alantrundle/P4-Airplay2-4inCtsLVGL/KiCAD PCB Files/P4-Audio-TFT/Footprints/FT6236_TOUCH/README.txt

V3 photo-corrected touch footprint
Common datum is panel centre. Place DS1 and TS1 at identical X/Y/rotation.
Panel/reference outline: 60.88 x 94.57 mm
6P connector centre: X=-8.50, Y=37.285 mm
Lower panel edge to 6P connector centre: 10.0 mm (short tail)
6P connector body LEFT edge aligns with 40P connector body LEFT edge.
3D model is bezel only, above TFT.
