alantrundle/P4-Airplay2-4inCtsLVGL/KiCAD PCB Files/P4-Audio-TFT/Footprints/ILI9488_TFT/README.txt

V3 photo-corrected TFT footprint
Common datum is panel centre. Place DS1 and TS1 at identical X/Y/rotation.
Panel: 60.88 x 94.57 mm
40P connector centre: X=0.00, Y=4.785 mm
Lower panel edge to 40P connector centre: 42.5 mm
TFT STEP bottom: 2.0 mm above PCB
