alantrundle/P4-Airplay2-4inCtsLVGL/KiCAD PCB Files/P4-Audio-TFT/Revision-in-progress.md

# Layout completed — 19 October 2026

The schematic, PCB, BOM, placement and Gerber/drill files are updated in this project. Native DRC, ERC, unconnected-item and schematic-parity checks all have zero findings. The current native reports are in validation/.

Use production/P4-Audio-TFT.zip, production/bom.csv and production/positions.csv together. Previous manufacturing files are archived in archive/production-before-release-20261019. A pre-release source backup is P4-Audio-TFT-before-release-20261019.zip.

Assembly sourcing is blocked: U1/P4 and U8/LD39150 have no JLC stock; U9/C6 has only two available for five boards. See the refreshed BOM workbook. This is a checked prototype layout, not tested hardware; the long SD-card routing and bring-up limits are described in Design-review.md and production/README.md.
