alantrundle/P4-Airplay2-4inCtsLVGL/KiCAD PCB Files/P4-PCB3-WIFI6-DB/Bottom-placement.png

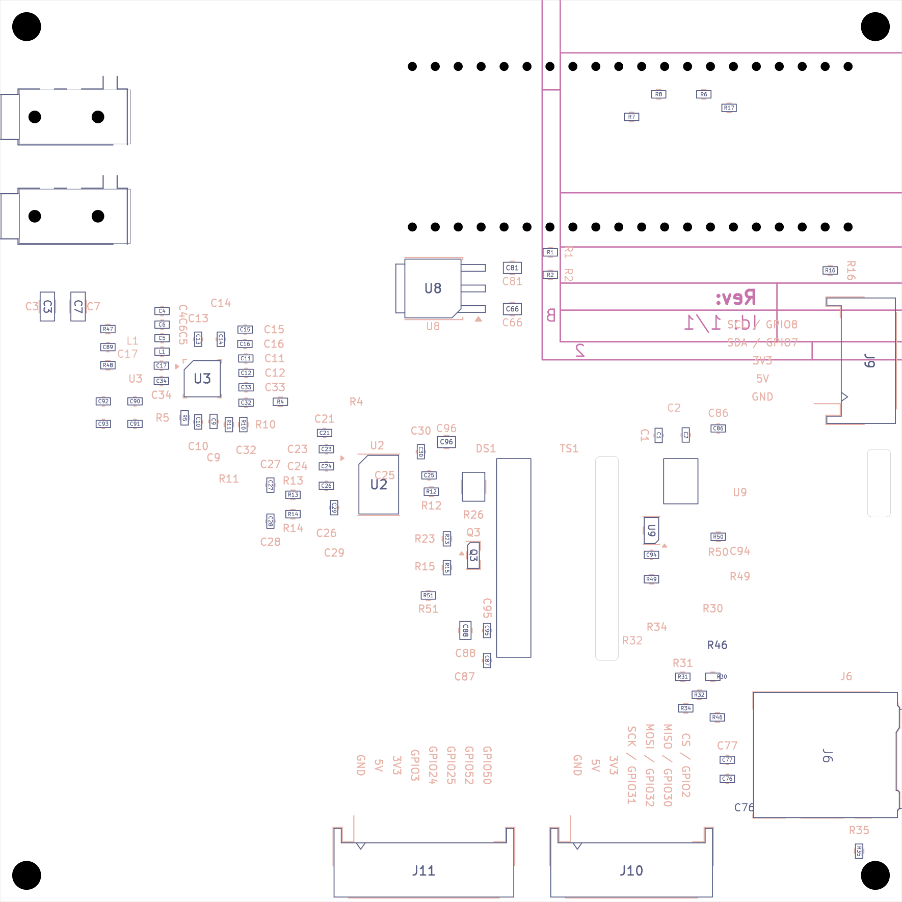
KiCAD PCB Files/P4-PCB3-WIFI6-DB/Bottom-placement.png
