alantrundle/P4-Airplay2-4inCtsLVGL/KiCAD PCB Files/P4-PCB3-WIFI6-DB/Top-placement.png

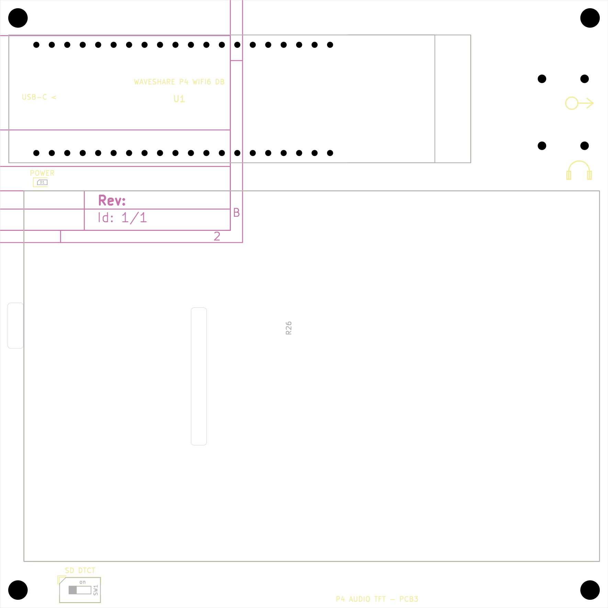
KiCAD PCB Files/P4-PCB3-WIFI6-DB/Top-placement.png
