alantrundle/P4-Airplay2-4inCtsLVGL/KiCAD PCB Files/P4-PCB3-WIFI6-DB/BOM-full.csv

Designator | Comment | Footprint | LCSC Part # | Quantity | Assembly | Notes
C1,C2 | 220pF | P4Local_Capacitor_SMD:C_0603_1608Metric | C1603 | 2 | Do not place | Optional I2C filter capacitors omitted.
C3,C7 | 100uF | P4Local_Capacitor_SMD:C_1206_3216Metric | C15008 | 2 | JLCPCB
C4 | 4.7uF | P4Local_Capacitor_SMD:C_0603_1608Metric | C19666 | 1 | JLCPCB
C5,C6,C10,C12,C14,C16,C17,C23,C25,C29,C30,C33,C34,C77,C86,C94,C95 | 100nF | P4Local_Capacitor_SMD:C_0603_1608Metric | C14663 | 17 | JLCPCB
C9,C11,C13,C15,C21,C32,C76 | 10uF | P4Local_Capacitor_SMD:C_0603_1608Metric | C19702 | 7 | JLCPCB
C24,C26,C89 | 2.2uF | P4Local_Capacitor_SMD:C_0603_1608Metric | C23630 | 3 | JLCPCB
C27,C28 | 2.2nF | P4Local_Capacitor_SMD:C_0603_1608Metric | C1604 | 2 | JLCPCB
C66,C81,C96 | 10uF | P4Local_Capacitor_SMD:C_0805_2012Metric | C15850 | 3 | JLCPCB
C87,C90,C91 | 1uF | P4Local_Capacitor_SMD:C_0603_1608Metric | C15849 | 3 | JLCPCB
C88 | 22uF | P4Local_Capacitor_SMD:C_0805_2012Metric | C45783 | 1 | JLCPCB
C92,C93 | 100pF | P4Local_Capacitor_SMD:C_0603_1608Metric | C14858 | 2 | JLCPCB
D1 | Green LED | P4Local_LED_SMD:LED_0603_1608Metric | C12624 | 1 | Manual fit | Top-side part excluded from bottom-only JLCPCB assembly; purchase separately and hand fit.
DS1 | FH34SRJ-40S-0.5SH(50) | P4Local_Updated:ILI9488_40P_4inch_Checked | C506798 | 1 | JLCPCB
J2,J3 | PJ-320D | P4Local_Connector_Audio_Han:HanElectricity_PJ320D_C22459515 | C22459515 | 2 | JLCPCB
J6 | DM3AT-SF-PEJM5 | P4Local_Connector_Card:microSD_HC_Hirose_DM3AT-SF-PEJM5 | C114218 | 1 | JLCPCB
J9 | S5B-PH-SM4-TB(LF)(SN) | P4Local_Connector_JST:JST_PH_S5B-PH-SM4-TB_1x05-1MP_P2.00mm_Horizontal | C265104 | 1 | JLCPCB
J10 | S7B-PH-SM4-TB(LF)(SN) | P4Local_Connector_JST:JST_PH_S7B-PH-SM4-TB_1x07-1MP_P2.00mm_Horizontal | C265453 | 1 | JLCPCB
J11 | S8B-PH-SM4-TB(LF)(SN) | P4Local_Connector_JST:JST_PH_S8B-PH-SM4-TB_1x08-1MP_P2.00mm_Horizontal | C265121 | 1 | JLCPCB
L1 | 600R@100MHz Ferrite | P4Local_Inductor_SMD:L_0603_1608Metric | C107335 | 1 | JLCPCB
Q3 | AO3400A | P4Local_Package_TO_SOT_SMD:SOT-23 | C20917 | 1 | JLCPCB
R1,R2 | 4.7k | P4Local_Resistor_SMD:R_0603_1608Metric | C23162 | 2 | JLCPCB
R4 | 10R | P4Local_Resistor_SMD:R_0603_1608Metric | C22859 | 1 | JLCPCB
R5,R6,R7,R8,R17 | 33R | P4Local_Resistor_SMD:R_0603_1608Metric | C23140 | 5 | JLCPCB
R10,R11 | 22R | P4Local_Resistor_SMD:R_0603_1608Metric | C23345 | 2 | JLCPCB
R12,R30,R31,R32,R34,R35,R46,R49,R50,R51 | 10k | P4Local_Resistor_SMD:R_0603_1608Metric | C25804 | 10 | JLCPCB
R13,R14 | 470R | P4Local_Resistor_SMD:R_0603_1608Metric | C23179 | 2 | JLCPCB
R15 | 100R | P4Local_Resistor_SMD:R_0603_1608Metric | C22775 | 1 | JLCPCB
R16 | 5.1k | P4Local_Resistor_SMD:R_0603_1608Metric | C23186 | 1 | JLCPCB
R23 | 100k | P4Local_Resistor_SMD:R_0603_1608Metric | C25803 | 1 | JLCPCB
R26 | 22R 0.5W | P4Local_Resistor_SMD:R_1210_3225Metric | C2960863 | 1 | JLCPCB
R47 | 1k | P4Local_Resistor_SMD:R_0603_1608Metric | C21190 | 1 | JLCPCB
R48 | 2k | P4Local_Resistor_SMD:R_0603_1608Metric | C22975 | 1 | JLCPCB
SW1 | EM-01KP | P4Local_Button_Switch_SMD:SW_DIP_SPSTx01_Slide_6.7x4.1mm_W8.61mm_P2.54mm_LowProfile | C129077 | 1 | Manual fit | Top-side part excluded from bottom-only JLCPCB assembly; purchase separately and hand fit.
TS1 | FH34SRJ-6S-0.5SH(50) | P4Local_FT6236_TOUCH:Hirose_FH34SRJ-6S-0.5SH_FT6236 | C224194 | 1 | JLCPCB
U1 | ESP32-P4-WIFI6-DB | P4Carrier:Waveshare_P4_WIFI6_DB_Sockets |  | 1 | Do not place | Customer-fitted Waveshare module. Fit two female socket strips separately.
U2 | PCM5102APWR | P4Local_Package_SO:TSSOP-20_4.4x6.5mm_P0.65mm | C107671 | 1 | JLCPCB
U3 | ES8388 | P4Local_Package_DFN_QFN:QFN-28-1EP_4x4mm_P0.45mm_EP2.6x2.6mm | C365736 | 1 | JLCPCB
U8 | LD39150DT33-R | P4Local_Package_TO_SOT_SMD:TO-252-3_TabPin2 | C155559 | 1 | JLCPCB
U9 | SN74LVC1G125DBVR | P4Local_Package_TO_SOT_SMD:SOT-23-5 | C23654 | 1 | JLCPCB
U1 socket A, U1 socket B | 1x20 female socket, 2.54 mm pitch | Through-hole, 1.0 mm holes | C50984 | 2 | Manual fit | Through-hole fallback. Two independent single-row strips, 17.78 mm apart. Standard-height part; no verified low-profile SMT substitute selected.
