alantrundle/P4-Airplay2-4inCtsLVGL/KiCAD PCB Files/P4-Audio-TFT/P4-Audio-TFT-BOM-review.xlsx

P4 Audio TFT — component sourcing
Checked 19 October 2026. Prices in USD; assembly fees, PCB, VAT and delivery excluded.
Boards | 5 |  | Stocked assembly parts estimate |  |  |  | $95.53
 |  |  | Estimate including stock exceptions |  |  |  | $159.83
Assembly sourcing blocked: U1/P4 and U8/LDO out of stock; U9/C6 only 2 available for five boards.
Class | Designators | Value | Package | Per board | For 5 boards | Allocate estimate | JLC stock | Unit USD | Line USD | Availability | LCSC code | Manufacturer part | Manufacturer | Assembly minimum | Wastage allowance | Fit | Notes | Source
Basic | R16, R24, R27 | 5.1k | 0603 | 3 | 15 | 25 | 23342336 | 0.0015 | 0.04 | In stock | C23186 | 0603WAF5101T5E | UNI-ROYAL(Uniroyal Elec) | 20 | 10 | JLC assembly |  | https://jlcpcb.com/partdetail/part/C23186
Basic | R10, R11 | 22R | 0603 | 2 | 10 | 20 | 7646846 | 0.0017 | 0.03 | In stock | C23345 | 0603WAF220JT5E | UNI-ROYAL(Uniroyal Elec) | 20 | 10 | JLC assembly |  | https://jlcpcb.com/partdetail/part/C23345
Basic | R54, R55, R56, R57, R58, R59 | 51k | 0603 | 6 | 30 | 40 | 2399299 | 0.0017 | 0.07 | In stock | C23196 | 0603WAF5102T5E | UNI-ROYAL(Uniroyal Elec) | 20 | 10 | JLC assembly |  | https://jlcpcb.com/partdetail/part/C23196
Basic | R13, R14 | 470R | 0603 | 2 | 10 | 20 | 5492068 | 0.0023 | 0.05 | In stock | C23179 | 0603WAF4700T5E | UNI-ROYAL(Uniroyal Elec) | 20 | 10 | JLC assembly |  | https://jlcpcb.com/partdetail/part/C23179
Basic | R5, R6, R7, R8, R17 | 33R | 0603 | 5 | 25 | 35 | 4875893 | 0.0024 | 0.08 | In stock | C23140 | 0603WAF330JT5E | UNI-ROYAL(Uniroyal Elec) | 20 | 10 | JLC assembly |  | https://jlcpcb.com/partdetail/part/C23140
Basic | R48 | 2k | 0603 | 1 | 5 | 20 | 11221424 | 0.0024 | 0.05 | In stock | C22975 | 0603WAF2001T5E | UNI-ROYAL(Uniroyal Elec) | 20 | 10 | JLC assembly |  | https://jlcpcb.com/partdetail/part/C22975
Basic | R15 | 100R | 0603 | 1 | 5 | 20 | 10630717 | 0.0025 | 0.05 | In stock | C22775 | 0603WAF1000T5E | UNI-ROYAL(Uniroyal Elec) | 20 | 10 | JLC assembly |  | https://jlcpcb.com/partdetail/part/C22775
Basic | R1, R2 | 4.7k | 0603 | 2 | 10 | 20 | 18421225 | 0.0028 | 0.06 | In stock | C23162 | 0603WAF4701T5E | UNI-ROYAL(Uniroyal Elec) | 20 | 10 | JLC assembly |  | https://jlcpcb.com/partdetail/part/C23162
Basic | R47 | 1k | 0603 | 1 | 5 | 20 | 22808225 | 0.0030 | 0.06 | In stock | C21190 | 0603WAF1001T5E | UNI-ROYAL(Uniroyal Elec) | 20 | 10 | JLC assembly |  | https://jlcpcb.com/partdetail/part/C21190
Basic | R23, R37 | 100k | 0603 | 2 | 10 | 20 | 19181265 | 0.0031 | 0.06 | In stock | C25803 | 0603WAF1003T5E | UNI-ROYAL(Uniroyal Elec) | 20 | 10 | JLC assembly |  | https://jlcpcb.com/partdetail/part/C25803
Basic | R4 | 10R | 0603 | 1 | 5 | 20 | 5995370 | 0.0032 | 0.06 | In stock | C22859 | 0603WAF100JT5E | UNI-ROYAL(Uniroyal Elec) | 20 | 10 | JLC assembly |  | https://jlcpcb.com/partdetail/part/C22859
Basic | R51 | 10M | 0603 | 1 | 5 | 20 | 1055279 | 0.0032 | 0.06 | In stock | C7250 | 0603WAF1005T5E | UNI-ROYAL(Uniroyal Elec) | 20 | 10 | JLC assembly |  | https://jlcpcb.com/partdetail/part/C7250
Basic | C101, C115, C118 | 100nF | 0402 | 3 | 15 | 25 | 29163879 | 0.0051 | 0.13 | In stock | C1525 | CL05B104KO5NNNC | Samsung Electro-Mechanics | 20 | 10 | JLC assembly |  | https://jlcpcb.com/partdetail/part/C1525
Basic | R3, R9, R12, R18, R25, R29, R30, R31, R32, R33, R34, R35, R36, R46, R52, R53, R61, R62 | 10k | 0603 | 18 | 90 | 100 | 39228014 | 0.0054 | 0.54 | In stock | C25804 | 0603WAF1002T5E | UNI-ROYAL(Uniroyal Elec) | 20 | 10 | JLC assembly |  | https://jlcpcb.com/partdetail/part/C25804
Basic | C122, C123, C124, C125, C126 | 22pF | 0603 | 5 | 25 | 35 | 2131614 | 0.0060 | 0.21 | In stock | C1653 | CL10C220JB8NNNC | Samsung Electro-Mechanics | 20 | 10 | JLC assembly |  | https://jlcpcb.com/partdetail/part/C1653
Basic | C99, C102, C116 | 1uF | 0402 | 3 | 15 | 25 | 8393820 | 0.0068 | 0.17 | In stock | C52923 | CL05A105KA5NQNC | Samsung Electro-Mechanics | 20 | 10 | JLC assembly |  | https://jlcpcb.com/partdetail/part/C52923
Basic | C1, C2 | 220pF | 0603 | 2 | 10 | 20 | 1167880 | 0.0072 | 0.14 | In stock | C1603 | CL10B221KB8NNNC | Samsung Electro-Mechanics | 20 | 10 | JLC assembly |  | https://jlcpcb.com/partdetail/part/C1603
Basic | C92, C93 | 100pF | 0603 | 2 | 10 | 20 | 3988044 | 0.0086 | 0.17 | In stock | C14858 | CL10C101JB8NNNC | Samsung Electro-Mechanics | 20 | 10 | JLC assembly |  | https://jlcpcb.com/partdetail/part/C14858
Basic | C5, C6, C10, C12, C14, C16, C17, C18, C19, C22, C23, C25, C29, C30, C33, C34, C65, C77, C82, C85, C86, C94, C95, C96, C103, C104, C105, C107, C109, C110, C112, C114, C117, C127, C129, C131, C132, C133, C136, C137 | 100nF | 0603 | 40 | 200 | 210 | 40118497 | 0.0108 | 2.27 | In stock | C14663 | CC0603KRX7R9BB104 | YAGEO | 20 | 10 | JLC assembly |  | https://jlcpcb.com/partdetail/part/C14663
Basic | C27, C28 | 2.2nF | 0603 | 2 | 10 | 20 | 978911 | 0.0109 | 0.22 | In stock | C1604 | 0603B222K500NT | FH (Guangdong Fenghua Advanced Tech) | 20 | 10 | JLC assembly |  | https://jlcpcb.com/partdetail/part/C1604
Basic | C24, C26, C89 | 2.2uF | 0603 | 3 | 15 | 25 | 3395818 | 0.0134 | 0.34 | In stock | C23630 | CL10A225KO8NNNC | Samsung Electro-Mechanics | 20 | 10 | JLC assembly |  | https://jlcpcb.com/partdetail/part/C23630
Basic | Q4, Q5 | S8050 | SOT-23 | 2 | 10 | 15 | 1421059 | 0.0147 | 0.22 | In stock | C2146 | S8050 J3Y(RANGE:200-350) | Jiangsu Changjing Electronics Technology Co., Ltd. | 10 | 5 | JLC assembly | Two Basic S8050s plus two existing-type 10k base resistors replace unavailable EMH4T2R (Q1). | https://jlcpcb.com/partdetail/part/C2146
Basic | C75, C87, C90, C91, C97, C98, C100, C135 | 1uF | 0603 | 8 | 40 | 50 | 15235435 | 0.0153 | 0.77 | In stock | C15849 | CL10A105KB8NNNC | Samsung Electro-Mechanics | 20 | 10 | JLC assembly |  | https://jlcpcb.com/partdetail/part/C15849
Basic | D1 | Green LED | 0805 | 1 | 5 | 20 | 2611569 | 0.0164 | 0.33 | In stock | C2297 | KT-0805G | Hubei KENTO Elec | 20 | 10 | JLC assembly | Changed indicator to Basic 0805 green LED with matching footprint. | https://jlcpcb.com/partdetail/part/C2297
Basic | C4, C119, C120 | 4.7uF | 0603 | 3 | 15 | 25 | 3459949 | 0.0218 | 0.55 | In stock | C19666 | CL10A475KO8NNNC | Samsung Electro-Mechanics | 20 | 10 | JLC assembly |  | https://jlcpcb.com/partdetail/part/C19666
Basic | C9, C11, C13, C15, C21, C31, C32, C76, C106, C108, C111, C113, C128, C134 | 10uF | 0603 | 14 | 70 | 80 | 10697332 | 0.0272 | 2.18 | In stock | C19702 | CL10A106KP8NNNC | Samsung Electro-Mechanics | 20 | 10 | JLC assembly |  | https://jlcpcb.com/partdetail/part/C19702
Basic | C121, C130 | 22uF | 0603 | 2 | 10 | 20 | 7011157 | 0.0312 | 0.62 | In stock | C59461 | CL10A226MQ8NRNC | Samsung Electro-Mechanics | 20 | 10 | JLC assembly | 22uF 6.3V X5R 0603 on the P4 low-voltage core rail; Basic replacement for 16V part. | https://jlcpcb.com/partdetail/part/C59461
Basic | D3 | SS34 | SMA(DO-214AC) | 1 | 5 | 13 | 3811369 | 0.0350 | 0.46 | In stock | C8678 | SS34 | MDD(Microdiode Semiconductor) | 5 | 8 | JLC assembly |  | https://jlcpcb.com/partdetail/part/C8678
Basic | C66, C81, C138 | 10uF | 0805 | 3 | 15 | 25 | 6398282 | 0.0874 | 2.19 | In stock | C15850 | CL21A106KAYNNNE | Samsung Electro-Mechanics | 20 | 10 | JLC assembly | 10uF 0805. Corrects C138 code/footprint mismatch; also C66/C81. | https://jlcpcb.com/partdetail/part/C15850
Basic | Q3 | AO3400A | SOT-23 | 1 | 5 | 9 | 1065444 | 0.0972 | 0.87 | In stock | C20917 | AO3400A | Alpha & Omega Semicon | 5 | 4 | JLC assembly |  | https://jlcpcb.com/partdetail/part/C20917
Basic | Q2 | AO3401A | SOT-23 | 1 | 5 | 9 | 746220 | 0.1021 | 0.92 | In stock | C15127 | AO3401A | Alpha & Omega Semicon | 5 | 4 | JLC assembly |  | https://jlcpcb.com/partdetail/part/C15127
Basic | C3, C7 | 100uF | 1206 | 2 | 10 | 14 | 1293050 | 0.1393 | 1.95 | In stock | C15008 | CL31A107MQHNNNE | Samsung Electro-Mechanics | 5 | 4 | JLC assembly | 100uF 1206 bulk capacitors; retain specified footprint. | https://jlcpcb.com/partdetail/part/C15008
Basic | Y2 | 32.768Khz | SMD3215-2P | 1 | 5 | 6 | 223998 | 0.1725 | 1.03 | In stock | C32346 | Q13FC13500004 | Seiko Epson | 5 | 1 | JLC assembly |  | https://jlcpcb.com/partdetail/part/C32346
Basic | C20, C88 | 22uF | 0805 | 2 | 10 | 14 | 3676747 | 0.1940 | 2.72 | In stock | C45783 | CL21A226MAQNNNE | Samsung Electro-Mechanics | 2 | 4 | JLC assembly | 22uF 0805 bulk capacitors; retain specified footprint. | https://jlcpcb.com/partdetail/part/C45783
Extended | R60 | 60.4k | 0603 | 1 | 5 | 20 | 86910 | 0.0015 | 0.03 | In stock | C23089 | 0603WAF6042T5E | UNI-ROYAL(Uniroyal Elec) | 20 | 10 | JLC assembly | 60.4k 1% sets a conservative upper current limit below 500mA, allowing for tolerance. Typical trip is lower. | https://jlcpcb.com/partdetail/part/C23089
Extended | R49, R50 | 499k | 0603 | 2 | 10 | 20 | 135992 | 0.0016 | 0.03 | In stock | C26751 | 0603WAF4993T5E | UNI-ROYAL(Uniroyal Elec) | 20 | 10 | JLC assembly | 499k 1% feedback resistors required for P4 v3.x. Extended; no exact Basic value found. | https://jlcpcb.com/partdetail/part/C26751
Extended | R26 | 16R 0.5W | 1210 | 1 | 5 | 15 | 18696 | 0.0092 | 0.14 | In stock | C2974063 | FRC1210F16R0TS | FOJAN | 15 | 4 | JLC assembly |  | https://jlcpcb.com/partdetail/part/C2974063
Extended | L1 | 600R@100MHz Ferrite | 0603 | 1 | 5 | 20 | 731585 | 0.0146 | 0.29 | In stock | C107335 | MPZ1608S601ATA00 | TDK | 20 | 10 | JLC assembly | 600ohm audio ferrite retained for its higher current/lower DCR versus the 200mA Basic candidate. | https://jlcpcb.com/partdetail/part/C107335
Extended | L2 | 1uH | 0806 | 1 | 5 | 20 | 70 | 0.0275 | 0.55 | In stock | C20616172 | IMTF201610C1R0MCTB | INMICRO | 20 | 6 | JLC assembly | Replaces unavailable 1uH part. 2.8A rated, 3.5A saturation, 58mohm; dedicated manufacturer land pattern. | https://jlcpcb.com/partdetail/part/C20616172
Extended | J2, J3 | PJ-320D | SMD | 2 | 10 | 11 | 2673 | 0.0301 | 0.33 | In stock | C22459515 | PJ-320D | HanElectricity | 2 | 1 | JLC assembly |  | https://jlcpcb.com/partdetail/part/C22459515
Extended | SW2 | SKRPACE010 | SMD-4P,4.2x3.2mm | 1 | 5 | 11 | 77367 | 0.0694 | 0.76 | In stock | C139797 | SKRPACE010 | ALPSALPINE | 5 | 6 | JLC assembly |  | https://jlcpcb.com/partdetail/part/C139797
Extended | U5 | TLV62569DBVR | SOT-23-5 | 1 | 5 | 9 | 455839 | 0.0706 | 0.64 | In stock | C141836 | TLV62569DBVR | Texas Instruments | 5 | 4 | JLC assembly |  | https://jlcpcb.com/partdetail/part/C141836
Extended | Y1 | 40Mhz | SMD3225-4P | 1 | 5 | 9 | 863 | 0.0724 | 0.65 | In stock | C5380316 | 3225 40M 12PF 10PPM | SST | 5 | 4 | JLC assembly |  | https://jlcpcb.com/partdetail/part/C5380316
Extended | TS1 | FH34SRJ-6S-0.5SH(50) | SMD,P=0.5mm,Surface Mount，Right Angle | 1 | 5 | 10 | 81000 | 0.0912 | 0.91 | In stock | C224194 | FH34SRJ-6S-0.5SH(50) | HRS(Hirose) | 5 | 5 | JLC assembly |  | https://jlcpcb.com/partdetail/part/C224194
Extended | SW3 | SK-12D02-G030 | 弯插,8.6x4.7mm | 1 | 5 | 5 | 1029 | 0.1235 | 0.62 | In stock | C5446808 | SK-12D02-G030 | G-Switch | 2 | 0 | JLC assembly |  | https://jlcpcb.com/partdetail/part/C5446808
Extended | J1 | TYPE-C-31-M-12 | SMD | 1 | 5 | 5 | 355876 | 0.1865 | 0.93 | In stock | C165948 | TYPE-C-31-M-12 | Korean Hroparts Elec | 2 | 0 | JLC assembly |  | https://jlcpcb.com/partdetail/part/C165948
Extended | BT1 | BS-12-B3AA011 | - | 1 | 5 | 5 | 8939 | 0.3013 | 1.51 | In stock | C964729 | BS-12-B3AA011 | MYOUNG | 5 | 0 | JLC assembly |  | https://jlcpcb.com/partdetail/part/C964729
Extended | J9, J12, J13 | S5B-PH-SM4-TB(LF)(SN) | SMD,P=2mm,Surface Mount，Right Angle | 3 | 15 | 15 | 10723 | 0.3419 | 5.13 | In stock | C265104 | S5B-PH-SM4-TB(LF)(SN) | JST | 5 | 0 | JLC assembly |  | https://jlcpcb.com/partdetail/part/C265104
Extended | DS1 | FH34SRJ-40S-0.5SH(50) | SMD,P=0.5mm,Surface Mount，Right Angle | 1 | 5 | 5 | 14103 | 0.3935 | 1.97 | In stock | C506798 | FH34SRJ-40S-0.5SH(50) | HRS(Hirose) | 1 | 0 | JLC assembly |  | https://jlcpcb.com/partdetail/part/C506798
Extended | J10 | S7B-PH-SM4-TB(LF)(SN) | SMD,P=2mm,Surface Mount，Right Angle | 1 | 5 | 5 | 5265 | 0.4409 | 2.20 | In stock | C265453 | S7B-PH-SM4-TB(LF)(SN) | JST | 1 | 0 | JLC assembly |  | https://jlcpcb.com/partdetail/part/C265453
Extended | J11 | S8B-PH-SM4-TB(LF)(SN) | SMD,P=2mm,Surface Mount，Right Angle | 1 | 5 | 5 | 18294 | 0.4540 | 2.27 | In stock | C265121 | S8B-PH-SM4-TB(LF)(SN) | JST | 1 | 0 | JLC assembly |  | https://jlcpcb.com/partdetail/part/C265121
Extended | U10 | TPS2553DBVR | SOT-23-6 | 1 | 5 | 5 | 52909 | 0.5405 | 2.70 | In stock | C55266 | TPS2553DBVR | Texas Instruments | 5 | 0 | JLC assembly |  | https://jlcpcb.com/partdetail/part/C55266
Extended | U4 | CH340C | SOP-16 | 1 | 5 | 5 | 123269 | 0.5438 | 2.72 | In stock | C84681 | CH340C | WCH(Jiangsu Qin Heng) | 1 | 0 | JLC assembly |  | https://jlcpcb.com/partdetail/part/C84681
Extended | SW1 | EM-01KP | SMD | 1 | 5 | 5 | 1943 | 0.5699 | 2.85 | In stock | C129077 | EM-01KP | Korean Hroparts Elec | 2 | 0 | JLC assembly |  | https://jlcpcb.com/partdetail/part/C129077
Extended | J5 | 67643-3911 | Push-Pull | 1 | 5 | 5 | 2547 | 0.9993 | 5.00 | In stock | C2765194 | 67643-3911 | MOLEX | 1 | 0 | JLC assembly |  | https://jlcpcb.com/partdetail/part/C2765194
Extended | U3 | ES8388 | QFN-28-EP(4x4) | 1 | 5 | 5 | 45855 | 1.1071 | 5.54 | In stock | C365736 | ES8388 | Everest-semi(Everest Semiconductor) | 1 | 0 | JLC assembly |  | https://jlcpcb.com/partdetail/part/C365736
Extended | J6 | DM3AT-SF-PEJM5 | SMD | 1 | 5 | 5 | 16464 | 1.3912 | 6.96 | In stock | C114218 | DM3AT-SF-PEJM5 | HRS(Hirose) | 1 | 0 | JLC assembly |  | https://jlcpcb.com/partdetail/part/C114218
Extended | U2 | PCM5102APWR | TSSOP-20 | 1 | 5 | 5 | 3701 | 1.4499 | 7.25 | In stock | C107671 | PCM5102APWR | Texas Instruments | 1 | 0 | JLC assembly |  | https://jlcpcb.com/partdetail/part/C107671
Extended | U9 | ESP32-C6-MINI-1-H4 | SMD,16.6x13.2mm | 1 | 5 | 5 | 2 | 4.4248 | 22.12 | Insufficient stock | C6553337 | ESP32-C6-MINI-1-H4 | Espressif Systems | 1 | 0 | JLC assembly | Internal-antenna H4 module retained. Only 2 in JLC stock on 19 October; insufficient for five boards. External-antenna 1U versions are not an automatic substitute. | https://jlcpcb.com/partdetail/part/C6553337
Extended | U6 | W25Q256JVEIQ | WSON-8-EP(6x8) | 1 | 5 | 5 | 10046 | 4.7824 | 23.91 | In stock | C97522 | W25Q256JVEIQ | Winbond Elec | 1 | 0 | JLC assembly | 32MB flash. Corrected from SOIC to WSON-8 8x6mm, EP3.4x4.3mm; exposed pad connected to GND. | https://jlcpcb.com/partdetail/part/C97522
Extended | U8 | LD39150DT33-R | DPAK | 1 | 5 | 5 | 0 | 2.2418 | 11.21 | Out of stock | C155559 | LD39150DT33-R | STMicroelectronics | 1 | 0 | JLC assembly | Requested Waveshare low-noise LDO retained. Out of JLC stock on 19 October; source/preorder required. | https://jlcpcb.com/partdetail/part/C155559
Extended | U1 | ESP32-P4NRW32X | QFN-104_10x10mm | 1 | 5 | 5 | 0 | 6.1931 | 30.97 | Out of stock | C54540373 | ESP32-P4NRW32X | Espressif Systems | 1 | 0 | JLC assembly | OUT OF STOCK. No stocked P4 variant found in the JLC catalogue. Supply/preorder required; do not substitute a consignment placeholder. | https://jlcpcb.com/partdetail/part/C54540373
Extended | J7 | Conn_01x04_Pin | Plugin,P=2.54mm | 1 | 5 | 5 | 14736 | 0.0213 | 0.11 | In stock | C42431787 | PZ2.54-1X4P-H25 | JXTCONN | 2 | 1 | Manual fit | C6 PROG header; manual fit, excluded from JLC assembly BOM. BOOT/RX/TX/GND. | https://jlcpcb.com/partdetail/part/C42431787
Extended | J8 | VBAT_SELECT | Push-Pull,P=2.54mm | 1 | 5 | 5 | 11589 | 0.0257 | 0.13 | In stock | C92159 | 2.54-1*3PStraight Bent Pin | BOOMELE(Boom Precision Elec) | 2 | 1 | Manual fit | RTC selector right-angle 1x3 2.54mm header; manual fit, excluded from assembly BOM. Requires one separate shunt. | https://jlcpcb.com/partdetail/part/C92159
n.a. | H1, H2, H3, H4 | MountingHole | 3.2mm M3 hole | 4 | 20 | 0 |  |  |  | Not purchased |  |  |  |  |  | PCB feature | Non-purchased PCB mounting hole.
