alantrundle/P4-Airplay2-4inCtsLVGL/KiCAD PCB Files/P4-Audio-TFT/archive/production-before-release-20261019/DO-NOT-FABRICATE.txt

Final high-speed routing review and manufacturing exports pending. Existing Gerbers and positions are stale. The saved PCB passes connectivity, clearance, silkscreen and schematic-parity checks; this is not yet the manufacturing release.
