alantrundle/P4-Airplay2-4inCtsLVGL/KiCAD PCB Files/P4-Audio-TFT/validation/bottom-assembly.png

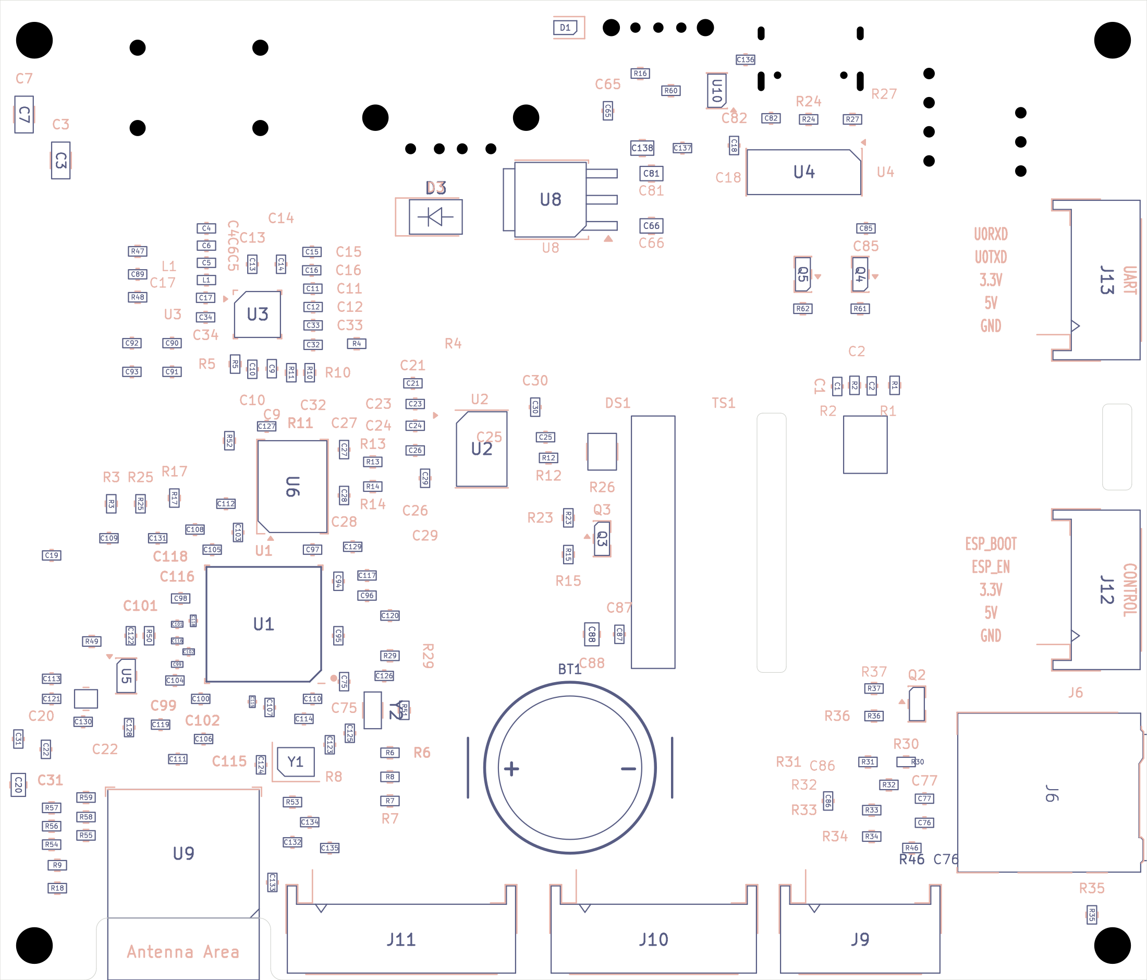
KiCAD PCB Files/P4-Audio-TFT/validation/bottom-assembly.png
