alantrundle/P4-Airplay2-4inCtsLVGL/sdio-investigation-v47.5/CHANGES-v47.5.txt

v47.5
-----
- Replaces non-working GCC @response-file include integration with explicit -I build flags.
- Fixes fatal compile error: sdio_drv.h: No such file or directory.
- Retains v47.4 cleanup of old src backups and no-copy source-tree architecture.
