alantrundle/P4-Airplay2-4inCtsLVGL/(list of files, drawings)

Other design files:
KiCAD PCB Files/P4-Audio-TFT/validation/schematic-erc.json
