alantrundle/P4-Airplay2-4inCtsLVGL/KiCAD PCB Files/P4-PCB3-WIFI6-DB/P4-PCB3-WIFI6-DB.kicad_pcb

## KiCad design KiCAD PCB Files/P4-PCB3-WIFI6-DB/P4-PCB3-WIFI6-DB.kicad_pcb (2026-10-20)

Schematic: P4-PCB3-WIFI6-DB.kicad_sch, PCB3 - Waveshare ESP32-P4 WIFI6 DB Audio / TFT Carrier

Parts:
C1, C2: 220pF; C_0603_1608Metric; LCSC C1603; not fitted
C3, C7: 100uF; C_1206_3216Metric; LCSC C15008
C4: 4.7uF; C_0603_1608Metric; LCSC C19666
C5, C6, C10, C12, C14, C16, C17, C23, C25, C29, C30, C33, C34, C77, C86, C94, C95: 100nF; C_0603_1608Metric; LCSC C14663
C9, C11, C13, C15, C21, C32, C76: 10uF; C_0603_1608Metric; LCSC C19702
C24, C26, C89: 2.2uF; C_0603_1608Metric; LCSC C23630
C27, C28: 2.2nF; C_0603_1608Metric; LCSC C1604
C66, C81, C96: 10uF; C_0805_2012Metric; LCSC C15850
C87, C90, C91: 1uF; C_0603_1608Metric; LCSC C15849
C88: 22uF; C_0805_2012Metric; LCSC C45783
C92, C93: 100pF; C_0603_1608Metric; LCSC C14858
D1: Green LED; LED_0603_1608Metric; LCSC C12624
DS1: FH34SRJ-40S-0.5SH(50); ILI9488_40P_4inch_Checked; MPN FH34SRJ-40S-0.5SH(50); LCSC C506798
H1, H2, H3, H4: MountingHole; MountingHole_3.2mm_M3; not fitted
J2, J3: PJ-320D; HanElectricity_PJ320D_C22459515; LCSC C22459515
J6: DM3AT-SF-PEJM5; microSD_HC_Hirose_DM3AT-SF-PEJM5; LCSC C114218
J9: S5B-PH-SM4-TB(LF)(SN); JST_PH_S5B-PH-SM4-TB_1x05-1MP_P2.00mm_Horizontal; MPN S5B-PH-SM4-TB(LF)(SN); LCSC C265104
J10: S7B-PH-SM4-TB(LF)(SN); JST_PH_S7B-PH-SM4-TB_1x07-1MP_P2.00mm_Horizontal; MPN S7B-PH-SM4-TB(LF)(SN); LCSC C265453
J11: S8B-PH-SM4-TB(LF)(SN); JST_PH_S8B-PH-SM4-TB_1x08-1MP_P2.00mm_Horizontal; MPN S8B-PH-SM4-TB(LF)(SN); LCSC C265121
L1: 600R@100MHz Ferrite; L_0603_1608Metric; LCSC C107335
Q3: AO3400A; SOT-23; LCSC C20917
R1, R2: 4.7k; R_0603_1608Metric; LCSC C23162
R4: 10R; R_0603_1608Metric; LCSC C22859
R5, R6, R7, R8, R17: 33R; R_0603_1608Metric; LCSC C23140
R10, R11: 22R; R_0603_1608Metric; LCSC C23345
R12, R30, R31, R32, R34, R35, R46, R49, R50, R51: 10k; R_0603_1608Metric; LCSC C25804
R13, R14: 470R; R_0603_1608Metric; LCSC C23179
R15: 100R; R_0603_1608Metric; LCSC C22775
R16: 5.1k; R_0603_1608Metric; LCSC C23186
R23: 100k; R_0603_1608Metric; LCSC C25803
R26: 22R 0.5W; R_1210_3225Metric; LCSC C2960863
R47: 1k; R_0603_1608Metric; LCSC C21190
R48: 2k; R_0603_1608Metric; LCSC C22975
SW1: EM-01KP; SW_DIP_SPSTx01_Slide_6.7x4.1mm_W8.61mm_P2.54mm_LowProfile; LCSC C129077
TS1: FH34SRJ-6S-0.5SH(50); Hirose_FH34SRJ-6S-0.5SH_FT6236; MPN FH34SRJ-6S-0.5SH(50); LCSC C224194
U1: ESP32-P4-WIFI6-DB; Waveshare_P4_WIFI6_DB_Sockets; not fitted
U2: PCM5102APWR; TSSOP-20_4.4x6.5mm_P0.65mm; LCSC C107671
U3: ES8388; QFN-28-1EP_4x4mm_P0.45mm_EP2.6x2.6mm; LCSC C365736
U8: LD39150DT33-R; TO-252-3_TabPin2; LCSC C155559
U9: SN74LVC1G125DBVR; SOT-23-5; LCSC C23654

Connections:
/ADC_MIC_N: C91.2, C93.1, U3.23 (RIN1)
/ADC_MIC_P: C90.2, C92.1, U3.24 (LIN1)
/ES8388_3V3: C4.1, C5.1, C6.1, C17.2, C32.1, C33.1, C34.2, L1.2, R4.2, U3.2 (DVDD), U3.3 (PVDD), U3.16 (HPVDD)
/ES_ASDOUT: R5.2, U3.8 (ASDOUT)
/ES_AVDD: C11.1, C12.1, R4.1, R47.1, U3.17 (AVDD)
/ES_BCLK: R6.2, U3.5 (SCLK)
/ES_DSDIN: R7.2, U3.6 (DSDIN)
/ES_LRCK: R8.2, U3.7 (LRCK)
/ES_MCLK: R17.2, U3.1 (MCLK)
/ES_OUTL: R10.1, U3.12 (LOUT1)
/ES_OUTR: R11.1, U3.11 (ROUT1)
/GND: C1.2, C2.2, C4.2, C5.2, C6.2, C9.2, C10.2, C11.2, C12.2, C13.2, C14.2, C15.2, C16.2, C17.1, C21.2, C23.1, C25.1, C26.1, C27.1, C28.1, C29.1, C30.1, C32.2, C33.2, C34.1, C66.2, C76.2, C77.2, C81.2, C86.2, C87.1, C88.1, C89.2, C91.1, C92.2, C93.2, C94.2, C95.2, C96.2, D1.1 (K), DS1.5 (GND), DS1.16 (GND), DS1.37 (GND), J2.R2 (Ring_2), J3.R2 (Ring_2), J3.S (Sleeve), J6.6 (VSS), J6.9 (CD_A), J6.SH (SHIELD), J9.1 (GND), J10.1 (GND), J11.1 (GND), Q3.2 (S), R23.1, TS1.6 (GND), U1.3 (GND), U1.8 (GND), U1.13 (GND), U1.18 (GND), U1.23 (GND), U1.28 (GND), U1.33 (GND), U1.38 (GND), U2.3 (CPGND), U2.9 (AGND), U2.10 (DEMP), U2.11 (FLT), U2.12 (SCK), U2.16 (FMT), U2.19 (DGND), U3.4 (DGND), U3.13 (HPGND), U3.18 (AGND), U3.29 (EPAD), U8.2 (GND), U9.3 (GND)
/GPIO2: J10.7 (GPIO5(CS)), U1.15 (GPIO2)
/GPIO3: J11.4 (GPIO13), U1.14 (GPIO3)
/GPIO24: J11.5 (GPIO22), U1.19 (GPIO24)
/GPIO25: J11.6 (GPIO34), U1.20 (GPIO25)
/GPIO50: J11.8 (GPIO50), U1.9 (GPIO50)
/GPIO52: J11.7 (GPIO49), U1.1 (GPIO52)
/HEADSET_MIC: C90.1, J2.S (Sleeve), R48.2
/Headphone_L: C3.2, J2.T (Tip)
/Headphone_R: C7.2, J2.R1 (Ring_1)
/I2C_SCL: C2.1, J9.5 (GPIO8(SCL)), R1.2, TS1.3 (SCL), U1.16 (GPIO8), U3.28 (CCLK)
/I2C_SDA: C1.1, J9.4 (GPIO7(SDA)), R2.2, TS1.2 (SDA), U1.17 (GPIO7), U3.27 (CDATA)
/I2S_ASDOUT: R5.1, U1.29 (GPIO26)
/I2S_BCLK: R6.1, U1.34 (GPIO21)
/I2S_DSDIN: R7.1, U1.31 (GPIO23)
/I2S_LRCK: R8.1, U1.32 (GPIO22)
/I2S_MCLK: R17.1, U1.35 (GPIO20)
/LDO_3V3: C21.1, C23.2, C29.2, C30.2, C76.1, C77.1, C81.1, C86.1, C87.2, C88.2, C94.1, C95.1, DS1.6 (VDDI), DS1.7 (VDD), DS1.12 (RDX), DS1.38 (IM0), DS1.39 (IM1), DS1.40 (IM2), J6.4 (VDD), J9.3 (3.3V), J10.3 (3.3V), J11.3 (3.3V), L1.1, R1.1, R2.1, R12.1, R30.1, R31.1, R32.1, R34.1, R35.1, R46.1, R49.1, R50.1, R51.1, TS1.1 (VDD), U2.1 (CPVDD), U2.8 (AVDD), U2.20 (DVDD), U3.26 (CE), U8.3 (OUT), U9.5 (VCC)
/LED_K: DS1.34 (LED_K), DS1.35 (LED_K), DS1.36 (LED_K), Q3.3 (D)
/Lineout_L: C27.2, J3.T (Tip), R13.2
/Lineout_R: C28.2, J3.R1 (Ring_1), R14.2
/MIC_BIAS_FILTERED: C89.1, R47.2, R48.1
/MODULE_5V: C66.1, C96.1, J9.2 (5V), J10.2 (5V), J11.2 (5V), R16.1, R26.1, U1.39 (VSYS), U8.1 (IN)
/N_C3_Pad1: C3.1, R10.2
/N_C7_Pad1: C7.1, R11.2
/N_D1_A: D1.2 (A), R16.2
/N_DS1_LED_A: DS1.33 (LED_A), R26.2
/N_J6_CD_B: J6.10 (CD_B), R35.2, SW1.2
/N_Q3_G: Q3.1 (G), R15.2, R23.2
/N_U2_CAPM: C24.1, U2.4 (CAPM)
/N_U2_CAPP: C24.2, U2.2 (CAPP)
/N_U2_LDOO: C25.2, U2.18 (LDOO)
/N_U2_OUTL: R13.1, U2.6 (OUTL)
/N_U2_OUTR: R14.1, U2.7 (OUTR)
/N_U2_VNEG: C26.2, U2.5 (VNEG)
/N_U2_XSMT: R12.2, U2.17 (XSMT)
/N_U3_ADCVREF: C13.1, C14.1, U3.19 (ADCVREF)
/N_U3_VMID: C15.1, C16.1, U3.20 (VMID)
/N_U3_VREF: C9.1, C10.1, U3.10 (VREF)
/PCM_BCLK: U1.27 (GPIO27), U2.13 (BCK)
/PCM_DATA: U1.7 (GPIO28), U2.14 (DIN)
/PCM_LRCK: U1.6 (GPIO29), U2.15 (LRCK)
/SD1_D1: J6.8 (DAT1), R46.2
/SD1_D2: J6.1 (DAT2), R30.2
/SD_CS: J6.2 (DAT3/CD), R31.2, U1.10 (GPIO49)
/SD_DETECT: SW1.1, U1.2 (GPIO51)
/TCH_INT: TS1.4 (INT), U1.11 (GPIO5)
/TCH_RST: R50.2, TS1.5 (RST), U1.12 (GPIO4)
/TFT_BL: R15.1, U1.21 (GPIO48)
/TFT_CS: DS1.9 (CSX_SPI_CS), R49.2, U1.24 (GPIO46), U9.1
/TFT_DC: DS1.10 (DCX_SPI_DC), U1.25 (GPIO33)
/TFT_MISO: J6.7 (DAT0), J10.6 (GPIO4(MISO)), R34.2, U1.5 (GPIO30), U9.4
/TFT_MOSI: DS1.13 (SPI_MOSI), J6.3 (CMD), J10.5 (GPIO3(MOSI)), R32.2, U1.26 (GPIO32)
/TFT_RESET: DS1.15 (RESET), R51.2, U1.22 (GPIO47)
/TFT_SCK: DS1.11 (WRX_SPI_SCLK), J6.5 (CLK), J10.4 (GPIO2(SCK)), U1.4 (GPIO31)
/TFT_SDO_RAW: DS1.14 (SPI_MISO), U9.2

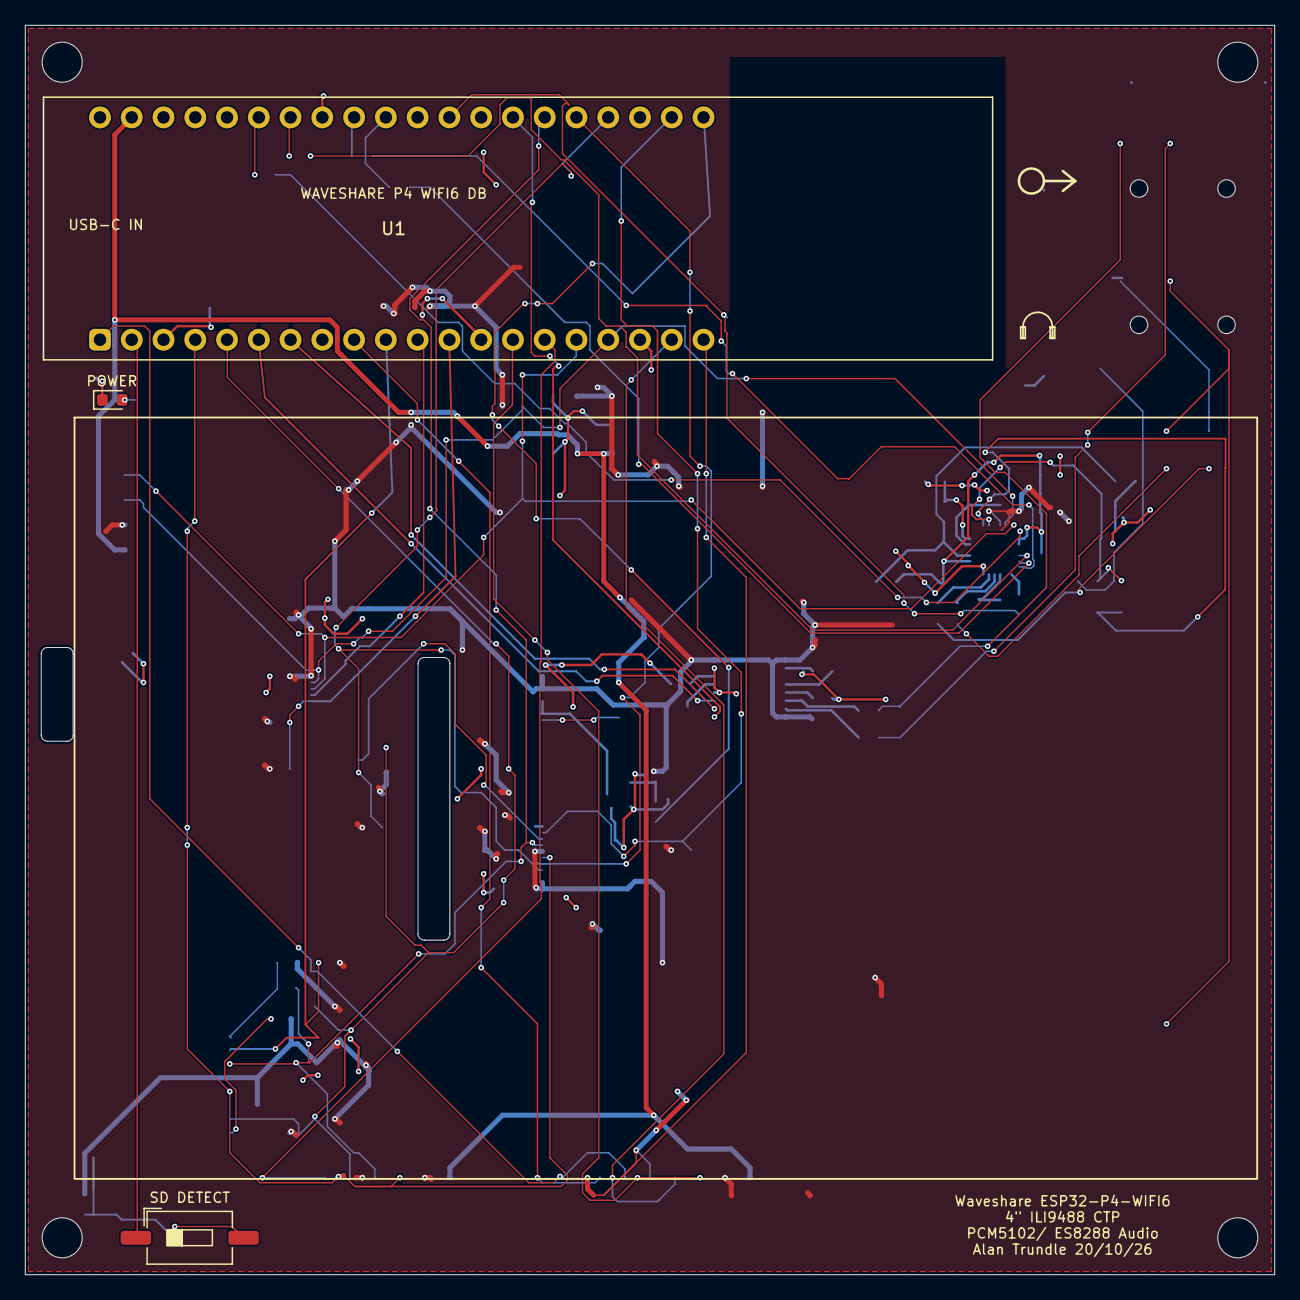
[picture p6: board P4-PCB3-WIFI6-DB.kicad_pcb from above]

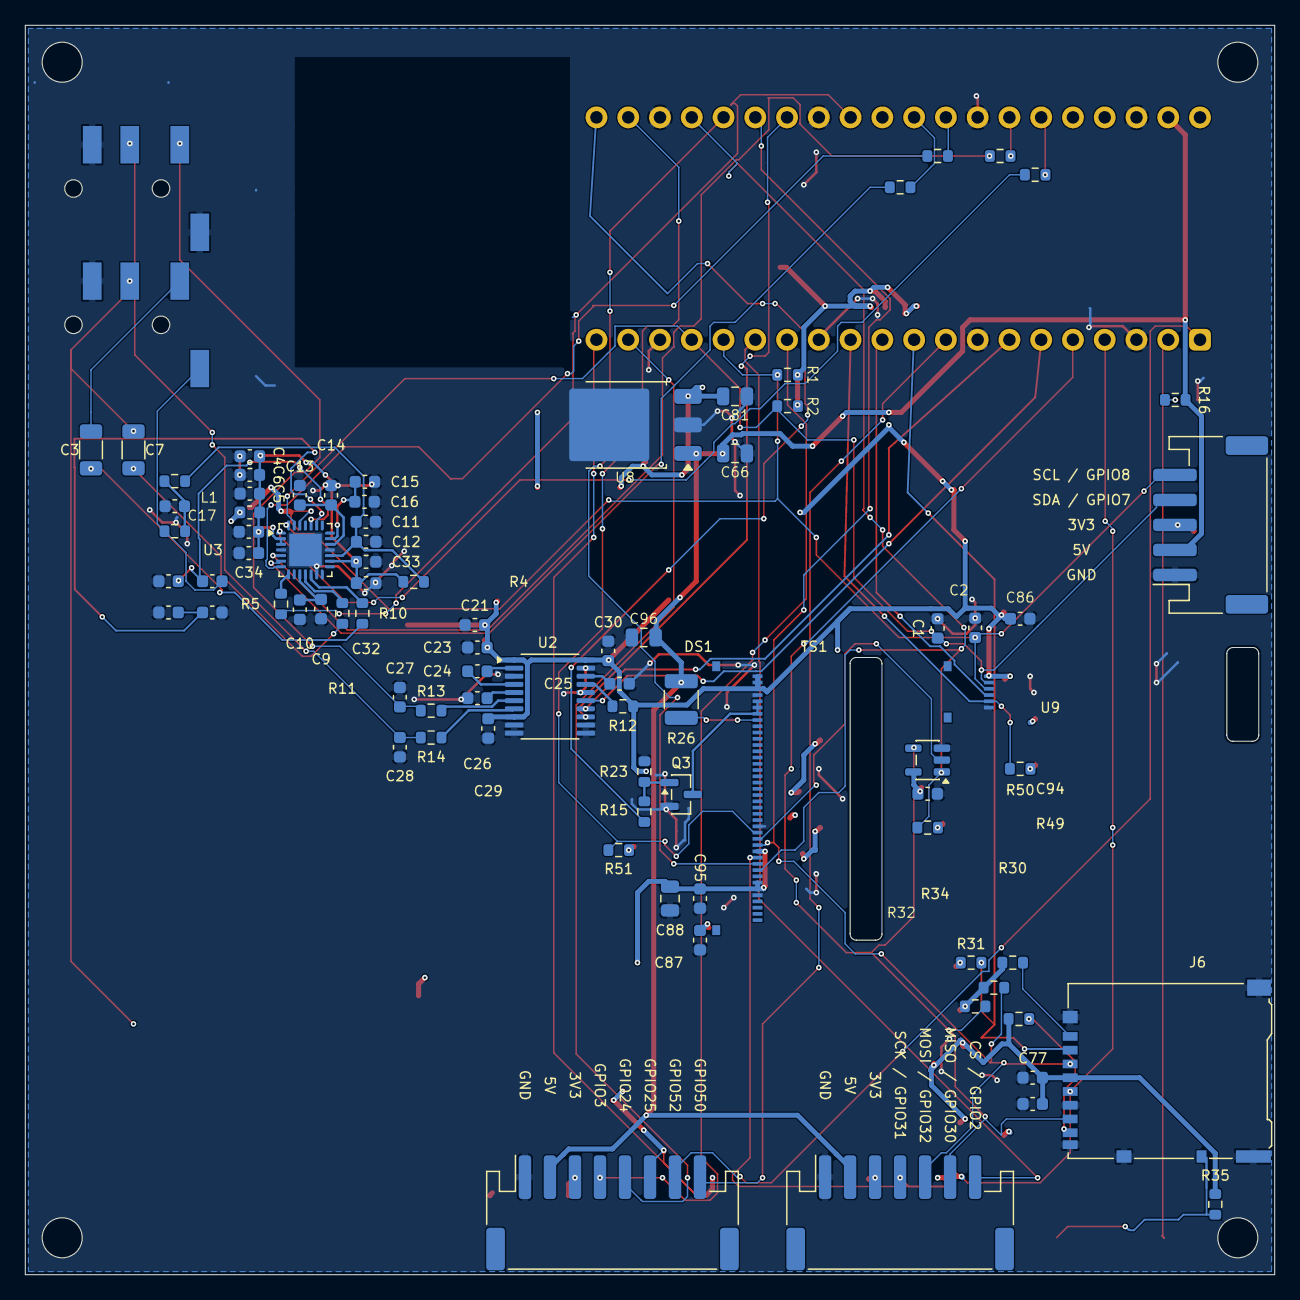
[picture p7: board P4-PCB3-WIFI6-DB.kicad_pcb from below]

Board: 2 copper layers, 99.9 x 99.9 mm, 92 parts (85 on the bottom side), 67 nets.
