alantrundle/P4-Airplay2-4inCtsLVGL/src/airplay2/audio/audio_stream_buffered.c

#include <errno.h>
#include <netinet/in.h>
#include <stdbool.h>
#include <stdint.h>
#include <stdlib.h>
#include <string.h>
#include <sys/socket.h>
#include <unistd.h>

#include "audio_receiver_internal.h"

#include "esp_heap_caps.h"
#include "esp_log.h"

#include "audio_crypto.h"
#include "network/socket_utils.h"

#define BUFFERED_AUDIO_PACKET_SIZE 8192
#define AUDIO_BUFFERED_STACK_SIZE  4096

static StaticTask_t s_buffered_tcb;
static StackType_t *s_buffered_stack;

static const char *TAG = "audio_buf";

// Read exact number of bytes, but keep waiting on timeout if paused
// Returns: positive = bytes read, 0 = connection closed, -1 = error
static ssize_t read_exact(audio_stream_t *stream, audio_receiver_state_t *state,
                          int sock, uint8_t *buf, size_t len) {
  size_t total = 0;
  while (total < len && stream->running) {
    ssize_t n = recv(sock, buf + total, len - total, 0);
    if (n > 0) {
      total += (size_t)n;
    } else if (n == 0) {
      // Connection closed by peer
      ESP_LOGI(TAG, "Buffered audio connection closed by peer");
      return 0;
    } else {
      // n < 0: error or timeout
      if (errno == EAGAIN || errno == EWOULDBLOCK) {
        // Timeout - if we're paused, keep waiting for resume
        if (!state->timing.playing) {
          // Still paused, keep the connection alive
          vTaskDelay(pdMS_TO_TICKS(100));
          continue;
        }
        // Playing but timed out - connection may be dead
        ESP_LOGW(TAG, "Buffered audio timeout while playing");
        return -1;
      }
      ESP_LOGE(TAG, "Buffered audio recv error: %d", errno);
      return -1;
    }
  }
  return stream->running ? (ssize_t)total : -1;
}

static void buffered_audio_task(void *pvParameters) {
  audio_stream_t *stream = (audio_stream_t *)pvParameters;
  audio_receiver_state_t *state = audio_stream_state(stream);

  while (stream->running) {
    struct sockaddr_in client_addr;
    socklen_t addr_len = sizeof(client_addr);

    int client_sock = accept(state->buffered_listen_socket,
                             (struct sockaddr *)&client_addr, &addr_len);
    if (client_sock < 0) {
      if (errno != EAGAIN && errno != EWOULDBLOCK && stream->running) {
        ESP_LOGE(TAG, "Buffered audio accept error: %d", errno);
      }
      vTaskDelay(pdMS_TO_TICKS(100));
      continue;
    }

    state->buffered_client_socket = client_sock;

    ESP_LOGI(TAG, "Buffered audio client connected fd=%d", client_sock);

    struct timeval tv = {.tv_sec = 30, .tv_usec = 0};
    setsockopt(client_sock, SOL_SOCKET, SO_RCVTIMEO, &tv, sizeof(tv));

    uint8_t *packet = state->buffered_recv_buffer;
    if (!packet) {
      packet = heap_caps_malloc(BUFFERED_AUDIO_PACKET_SIZE,
                                MALLOC_CAP_SPIRAM | MALLOC_CAP_8BIT);
      if (!packet) {
        packet = malloc(BUFFERED_AUDIO_PACKET_SIZE);
      }
      if (!packet) {
        ESP_LOGE(TAG, "Failed to allocate buffered audio packet buffer");
        close(client_sock);
        state->buffered_client_socket = -1;
        continue;
      }
      state->buffered_recv_buffer = packet;
    }

    uint32_t packet_count = 0;

    while (stream->running) {
      // Back-pressure: if buffer is nearly full, pause reading to let TCP
      // flow control slow down the sender. This prevents buffer overflow
      // and keeps frames in order.
      while (audio_buffer_is_nearly_full(&state->buffer) && stream->running) {
        vTaskDelay(pdMS_TO_TICKS(10));
      }

      uint8_t len_buf[2];
      if (read_exact(stream, state, client_sock, len_buf, 2) != 2) {
        break;
      }

      uint16_t data_len = (uint16_t)((len_buf[0] << 8) | len_buf[1]);
      if (data_len < 2 || data_len > BUFFERED_AUDIO_PACKET_SIZE) {
        ESP_LOGW(TAG, "Invalid buffered audio packet length: %u", data_len);
        break;
      }

      size_t packet_len = data_len - 2;
      if (read_exact(stream, state, client_sock, packet, packet_len) !=
          (ssize_t)packet_len) {
        break;
      }

      state->stats.packets_received++;

      uint32_t seq_no = (packet[1] << 16) | (packet[2] << 8) | packet[3];
      uint32_t timestamp =
          (packet[4] << 24) | (packet[5] << 16) | (packet[6] << 8) | packet[7];

      uint8_t *decrypted = state->decrypt_buffer;
      size_t decrypt_capacity = state->decrypt_buffer_size;
      if (!decrypted) {
        decrypted = packet + 12;
        decrypt_capacity = packet_len > 12 ? packet_len - 12 : 0;
      }

      int decrypted_len = audio_crypto_decrypt_buffered(
          &stream->encrypt, packet, packet_len, decrypted, decrypt_capacity);
      if (decrypted_len < 0) {
        state->stats.decrypt_errors++;
        state->stats.packets_dropped++;
        continue;
      }

      state->stats.last_seq = (uint16_t)(seq_no & 0xFFFF);
      state->stats.last_timestamp = timestamp;

      state->blocks_read++;
      state->blocks_read_in_sequence++;

      bool processed =
          audio_stream_process_frame(state, timestamp, decrypted,
                                     (size_t)decrypted_len);
      if (!processed) {
        state->stats.packets_dropped++;
      }

      packet_count++;
      if (packet_count <= 5 || (packet_count % 100) == 0) {
        ESP_LOGI(TAG,
                 "Buffered packet #%lu wire=%u payload=%u decrypted=%d "
                 "seq=%lu ts=%lu processed=%d queued=%d",
                 (unsigned long)packet_count,
                 (unsigned)data_len,
                 (unsigned)packet_len,
                 decrypted_len,
                 (unsigned long)seq_no,
                 (unsigned long)timestamp,
                 processed ? 1 : 0,
                 audio_buffer_get_frame_count(&state->buffer));
      }
    }

    ESP_LOGI(TAG, "Buffered audio client closing fd=%d packets=%lu",
             client_sock, (unsigned long)packet_count);
    close(client_sock);
    state->buffered_client_socket = -1;
  }

  state->buffered_task_handle = NULL;
  vTaskDelete(NULL);
}

static esp_err_t buffered_start(audio_stream_t *stream, uint16_t port) {
  audio_receiver_state_t *state = audio_stream_state(stream);
  if (stream->running) {
    ESP_LOGI(TAG, "Buffered audio already running, continuing");
    return ESP_OK;
  }

  uint16_t bound_port = port;
  state->buffered_listen_socket =
      socket_utils_bind_tcp_listener(port, 1, true, &bound_port);
  if (state->buffered_listen_socket < 0) {
    return ESP_FAIL;
  }
  state->buffered_port = bound_port;

  ESP_LOGI(TAG, "Buffered listener started requested=%u bound=%u fd=%d",
           (unsigned)port, (unsigned)bound_port,
           state->buffered_listen_socket);

  stream->running = true;

  // Allocate stack from SPIRAM on first use — the buffered task only does
  // socket I/O and decryption, no SPI flash access, so SPIRAM is safe.
  // This avoids competing with BT/WiFi/display for scarce internal DRAM.
  if (!s_buffered_stack) {
    s_buffered_stack = heap_caps_malloc(AUDIO_BUFFERED_STACK_SIZE,
                                        MALLOC_CAP_SPIRAM | MALLOC_CAP_8BIT);
    if (!s_buffered_stack) {
      // Fallback to any available memory
      s_buffered_stack = malloc(AUDIO_BUFFERED_STACK_SIZE);
    }
    if (!s_buffered_stack) {
      ESP_LOGE(TAG, "Failed to allocate buffered audio stack");
      close(state->buffered_listen_socket);
      state->buffered_listen_socket = -1;
      stream->running = false;
      return ESP_ERR_NO_MEM;
    }
  }

  state->buffered_task_handle =
      xTaskCreateStatic(buffered_audio_task, "buff_audio",
                        AUDIO_BUFFERED_STACK_SIZE / sizeof(StackType_t), stream,
                        5, s_buffered_stack, &s_buffered_tcb);
  if (!state->buffered_task_handle) {
    ESP_LOGE(TAG, "Failed to create buffered audio task");
    close(state->buffered_listen_socket);
    state->buffered_listen_socket = -1;
    stream->running = false;
    return ESP_FAIL;
  }

  return ESP_OK;
}

static void buffered_stop(audio_stream_t *stream) {
  audio_receiver_state_t *state = audio_stream_state(stream);

  stream->running = false;

  if (state->buffered_client_socket >= 0) {
    shutdown(state->buffered_client_socket, SHUT_RDWR);
    close(state->buffered_client_socket);
    state->buffered_client_socket = -1;
  }

  if (state->buffered_listen_socket >= 0) {
    shutdown(state->buffered_listen_socket, SHUT_RDWR);
    close(state->buffered_listen_socket);
    state->buffered_listen_socket = -1;
  }

  if (state->buffered_task_handle) {
    const TickType_t wait_step = pdMS_TO_TICKS(20);
    const int max_waits = 100;
    for (int i = 0; i < max_waits && state->buffered_task_handle; ++i) {
      vTaskDelay(wait_step);
    }

    if (state->buffered_task_handle) {
      ESP_LOGW(TAG,
               "Buffered task did not exit within 2 s; leaving receive memory intact");
    }
  }

  if (!state->buffered_task_handle && state->buffered_recv_buffer) {
    heap_caps_free(state->buffered_recv_buffer);
    state->buffered_recv_buffer = NULL;
  }

  state->buffered_port = 0;
  ESP_LOGI(TAG, "Buffered transport stopped");
}

static uint16_t buffered_get_port(audio_stream_t *stream) {
  audio_receiver_state_t *state = audio_stream_state(stream);
  return state->buffered_port;
}

static bool buffered_is_running(audio_stream_t *stream) {
  return stream->running;
}

static void buffered_destroy(audio_stream_t *stream) {
  if (!stream) {
    return;
  }

  buffered_stop(stream);
  free(stream);
}

const audio_stream_ops_t audio_stream_buffered_ops = {
    .start = buffered_start,
    .stop = buffered_stop,
    .receive_packet = NULL,
    .decrypt_payload = NULL,
    .get_port = buffered_get_port,
    .is_running = buffered_is_running,
    .destroy = buffered_destroy};
