alantrundle/P4-Airplay2-4inCtsLVGL/src/airplay2/audio/audio_decoder.h

#pragma once

#include <stdbool.h>
#include <stddef.h>
#include <stdint.h>

#include "audio_receiver.h"

#ifdef __cplusplus
extern "C" {
#endif

typedef struct audio_decoder audio_decoder_t;

typedef struct {
    audio_format_t format;
} audio_decoder_config_t;

typedef struct {
    int channels;
} audio_decode_info_t;

/*
 * NOTE ABOUT "output_capacity_samples":
 *
 * In the existing AirPlay audio pipeline this value is the number of
 * PCM samples PER CHANNEL, i.e. PCM frames.
 *
 * Example:
 *
 *   capacity = 4096
 *   channels = 2
 *
 * means the buffer physically contains room for:
 *
 *   4096 * 2 int16_t values
 *
 * audio_decoder_decode() returns the number of decoded PCM frames
 * (samples per channel), NOT the total number of interleaved int16_t values.
 */
audio_decoder_t *audio_decoder_create(const audio_decoder_config_t *config);

void audio_decoder_destroy(audio_decoder_t *decoder);

int audio_decoder_decode(audio_decoder_t *decoder,
                         const uint8_t *input,
                         size_t input_len,
                         int16_t *output,
                         size_t output_capacity_samples,
                         audio_decode_info_t *info);

bool audio_decoder_is_aac(const audio_decoder_t *decoder);

bool audio_decoder_is_alac(const audio_decoder_t *decoder);

#ifdef __cplusplus
}
#endif
