alantrundle/P4-Airplay2-4inCtsLVGL/(commit log)

2026-08-31 Added draft KiCAD PCB files
2026-09-05 PCB Design started
2026-09-05 2nd PCB edit
2026-10-19 PCB WS and P4-C6 complete
2026-10-19 tidied PCB files - production
2026-10-20 kicad files
